rgraetz/cubli-redux/ME_Design/_AssembledMotorFlyWheel.FCStd

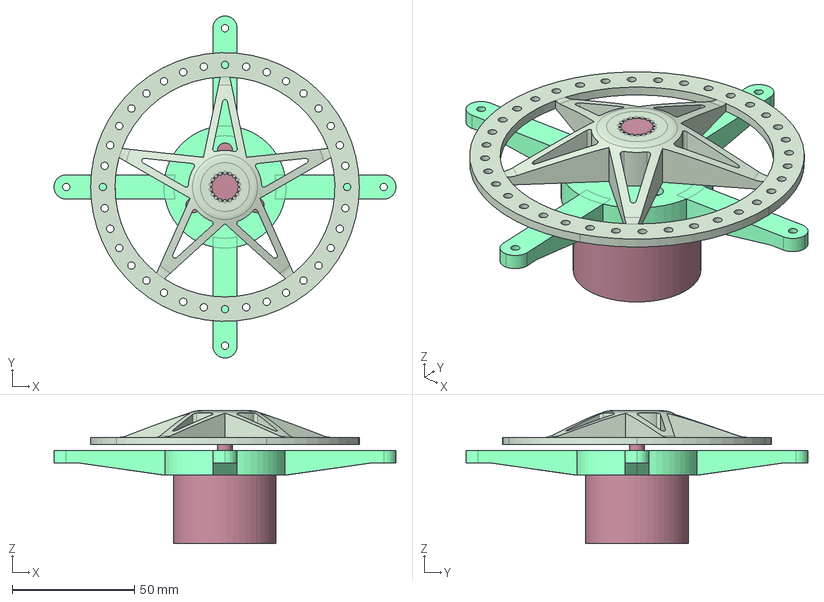
[picture p1: CAD file, 2022-12-11]
ME_Design/_AssembledMotorFlyWheel.FCStd
140.0 x 140.0 x 54.5 mm
Motor_001
MotorMount_001
ReactionWheel_001
