rgraetz/cubli-redux/ME_Design/_AssembledParts.FCStd

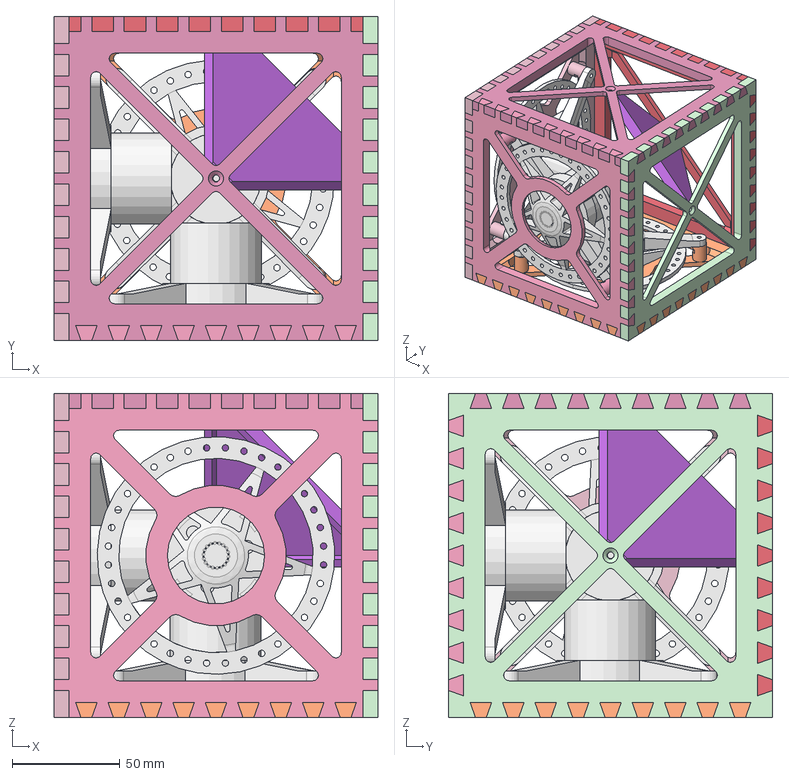
[picture p2: CAD file, 2022-12-11]
ME_Design/_AssembledParts.FCStd
150.0 x 150.0 x 150.0 mm
MotorSide_001
MotorSide_002
MotorSideKey_001
OtherSide_001
OtherSide_002
OtherSideKey_001
ElectronicsMount_001
_AssembledMotorFlyWheel_001
_AssembledMotorFlyWheel_002
_AssembledMotorFlyWheel_003
