rgraetz/cubli-redux/ME_Design/_backup/MotorSide.FCStd

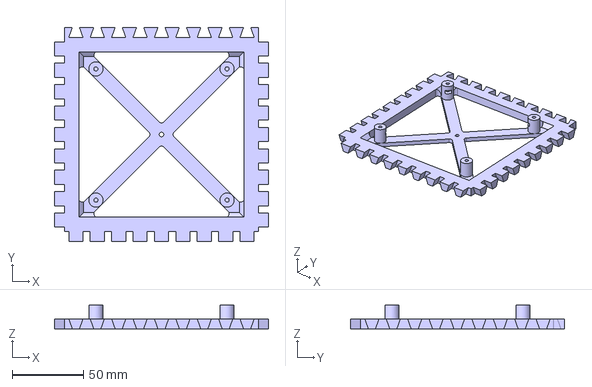
[picture p3: CAD file, 2022-12-11]
ME_Design/_backup/MotorSide.FCStd
150.0 x 150.0 x 16.5 mm
