rgraetz/cubli-redux/ME_Design/ElectronicsMount.FCStd

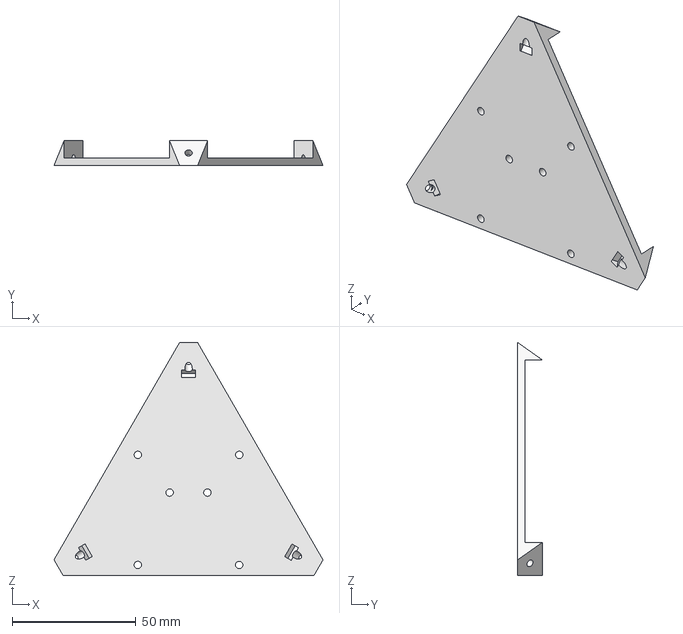
[picture p4: CAD file, 2022-12-11]
ME_Design/ElectronicsMount.FCStd
108.8 x 10.0 x 94.2 mm
