rgraetz/cubli-redux/ME_Design/Exports/ElectronicsMount-Part.3mf

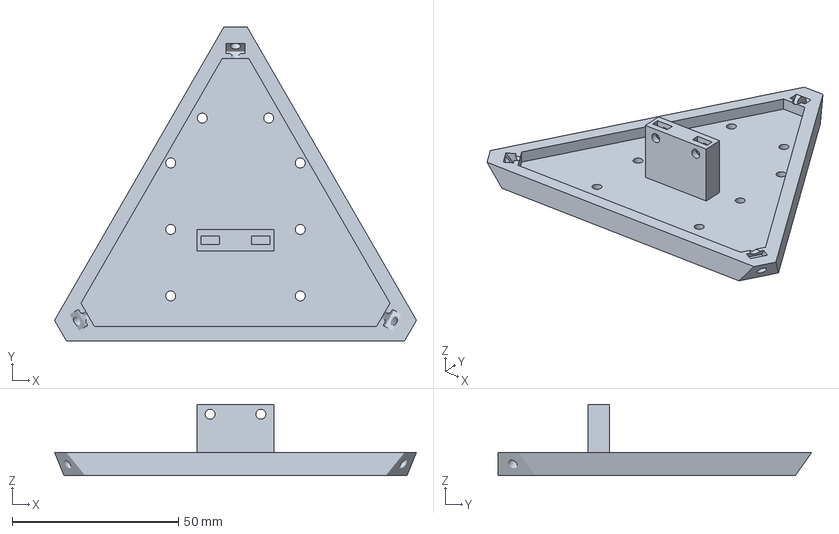
[picture p5: CAD file, 2022-12-11]
ME_Design/Exports/ElectronicsMount-Part.3mf
109.0 x 94.4 x 21.5 mm
