rgraetz/cubli-redux/ME_Design/_backup/MotorSideKey.FCStd

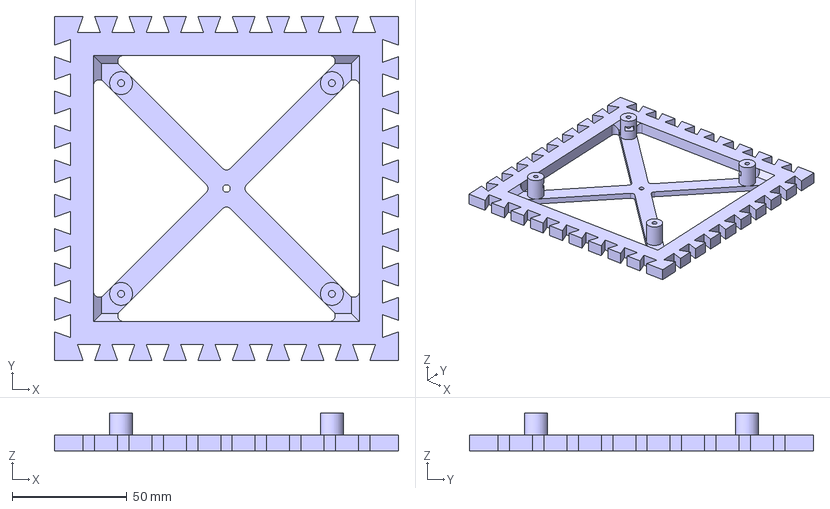
[picture p6: CAD file, 2022-12-11]
ME_Design/_backup/MotorSideKey.FCStd
150.0 x 150.0 x 16.5 mm
