rgraetz/cubli-redux/ME_Design/Exports/MotorSideKey-Part.stl

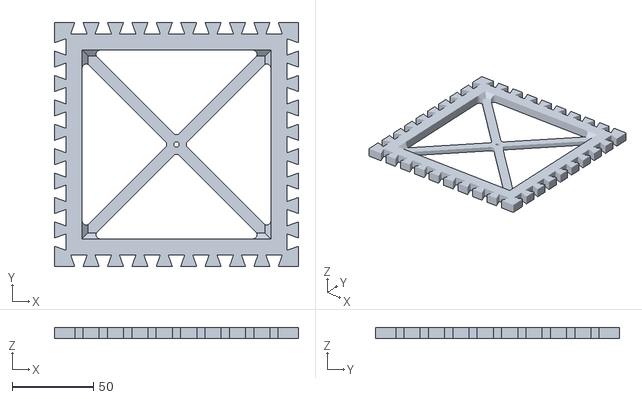
[picture p7: CAD file, 2022-12-11]
ME_Design/Exports/MotorSideKey-Part.stl
150.0 x 150.0 x 7.00
