rgraetz/cubli-redux/ME_Design/reaction_wheel_cube_3.stl

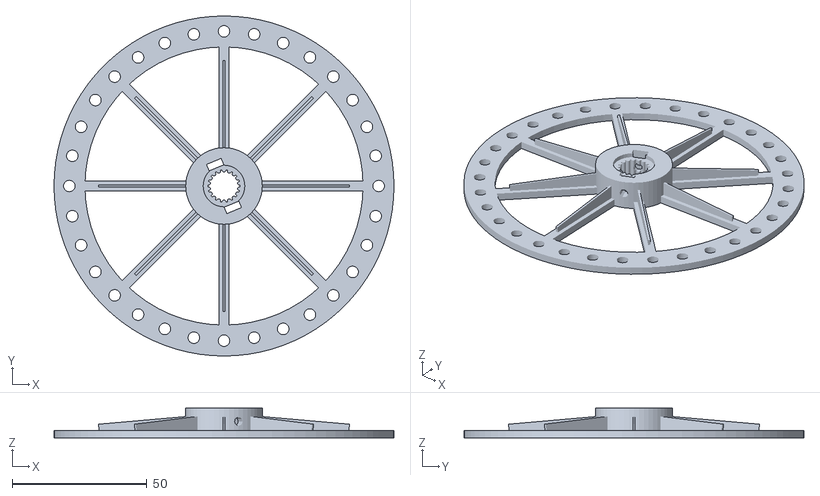
[picture p8: CAD file, 2022-12-11]
ME_Design/reaction_wheel_cube_3.stl
126.4 x 126.4 x 11.0
