rgraetz/cubli-redux/ME_Design/Exports/MotorSideKey-Part_DoveTest.stl

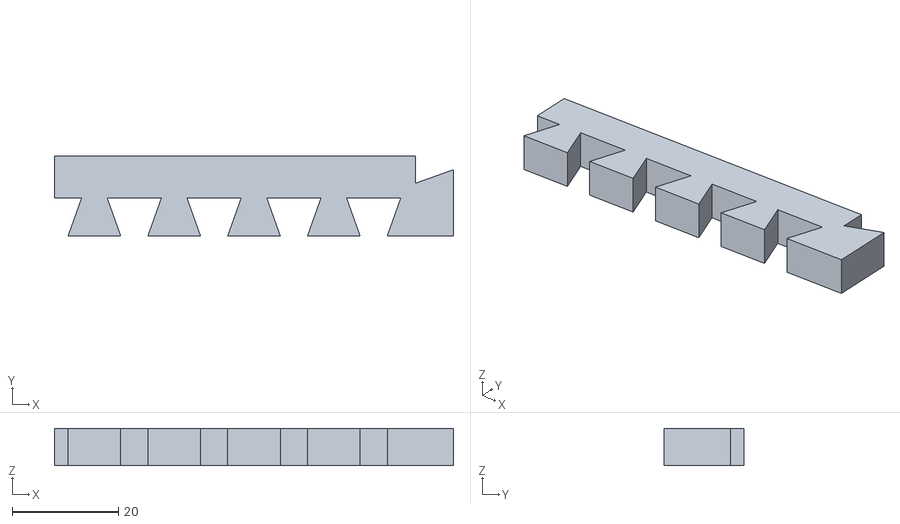
[picture p10: CAD file, 2022-12-11]
ME_Design/Exports/MotorSideKey-Part_DoveTest.stl
75.0 x 15.0 x 7.00
