rgraetz/cubli-redux/ME_Design/reaction_wheel_cube_2.stl

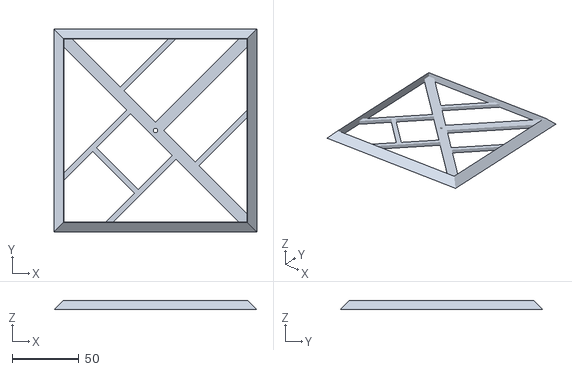
[picture p11: CAD file, 2022-12-11]
ME_Design/reaction_wheel_cube_2.stl
152.0 x 152.0 x 7.00
