rgraetz/cubli-redux/ME_Design/imuMount-Body.stl

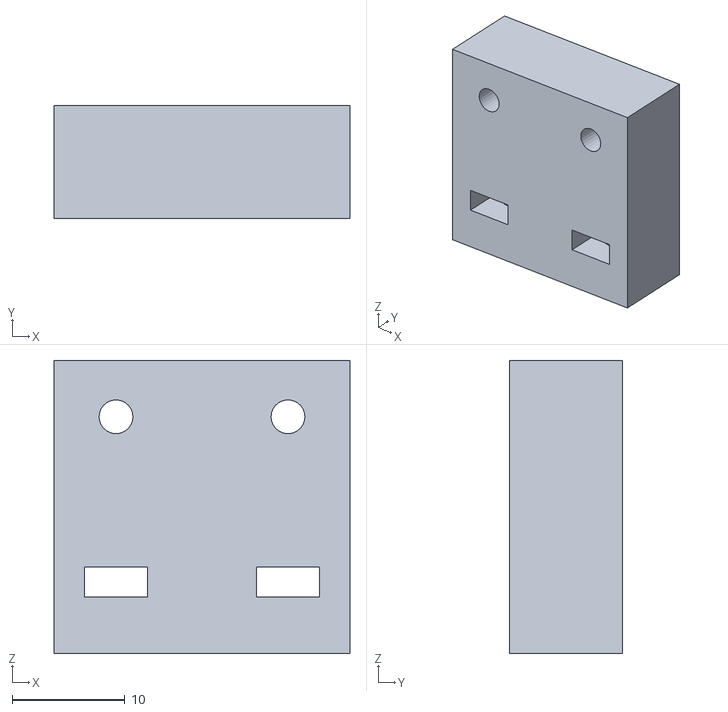
[picture p12: CAD file, 2022-12-11]
ME_Design/imuMount-Body.stl
26.2 x 10.0 x 26.0
