rgraetz/cubli-redux/ME_Design/reaction_wheel_cube_5.stl

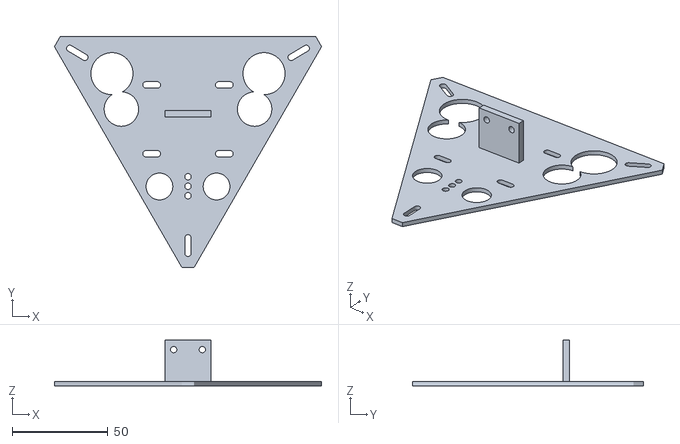
[picture p13: CAD file, 2022-12-11]
ME_Design/reaction_wheel_cube_5.stl
139.6 x 120.8 x 24.0
