rgraetz/cubli-redux/ME_Design/Exports/MotorMount-Part.3mf

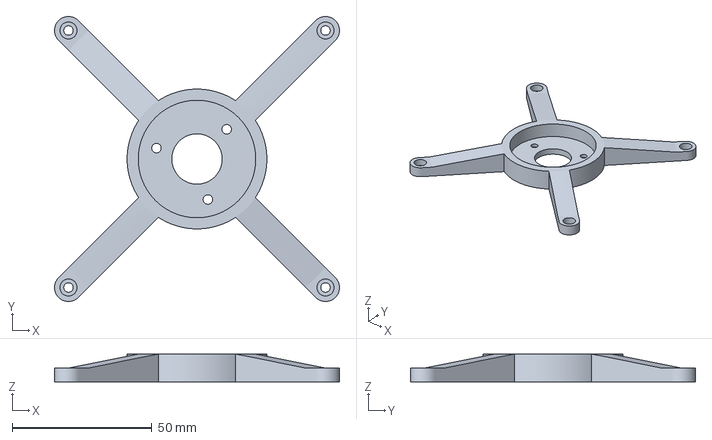
[picture p14: CAD file, 2022-12-11]
ME_Design/Exports/MotorMount-Part.3mf
101.9 x 101.9 x 10.0 mm
