rgraetz/cubli-redux/ME_Design/reaction_wheel_cube_8.stl

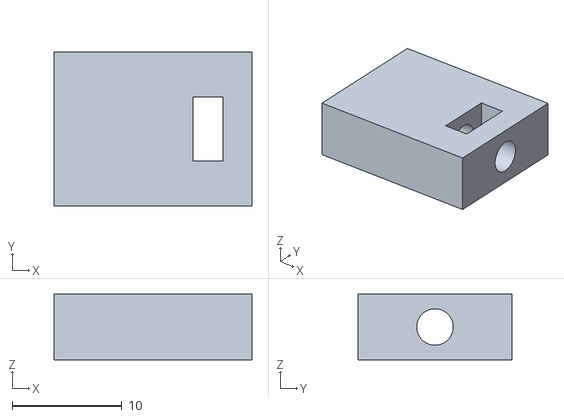
[picture p15: CAD file, 2022-12-11]
ME_Design/reaction_wheel_cube_8.stl
18.0 x 14.0 x 6.00
