rgraetz/cubli-redux/ME_Design/Exports/MotorSide-Part.stl

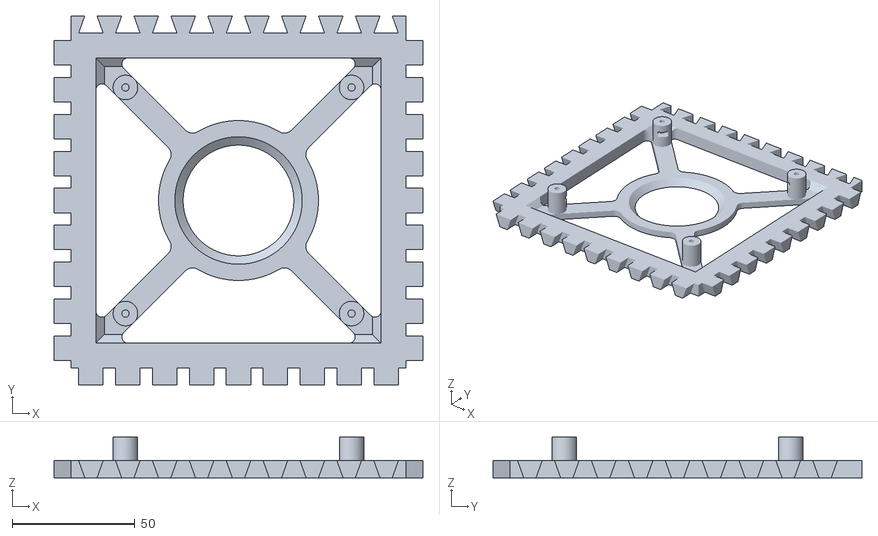
[picture p16: CAD file, 2022-12-11]
ME_Design/Exports/MotorSide-Part.stl
150.0 x 150.0 x 16.5
