rgraetz/cubli-redux/ME_Design/BatteryMount-Body.stl

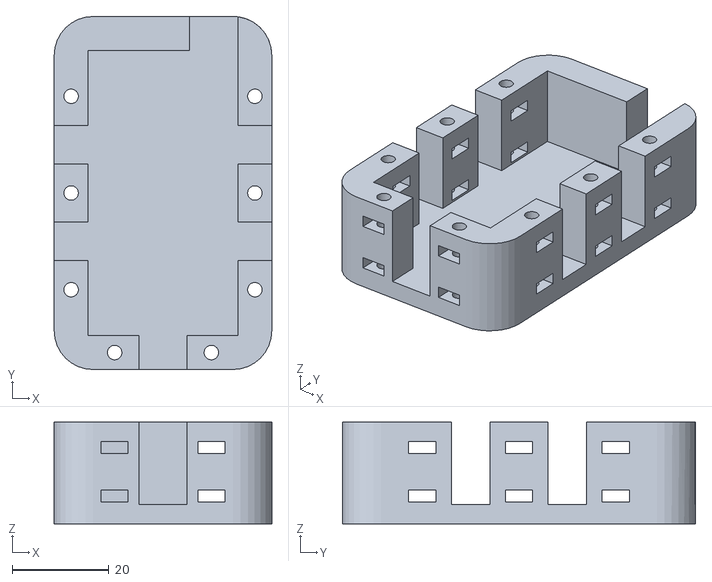
[picture p17: CAD file, 2022-12-11]
ME_Design/BatteryMount-Body.stl
45.0 x 73.0 x 21.0
