rgraetz/cubli-redux/ME_Design/Exports/ReactionWheel-Part.3mf

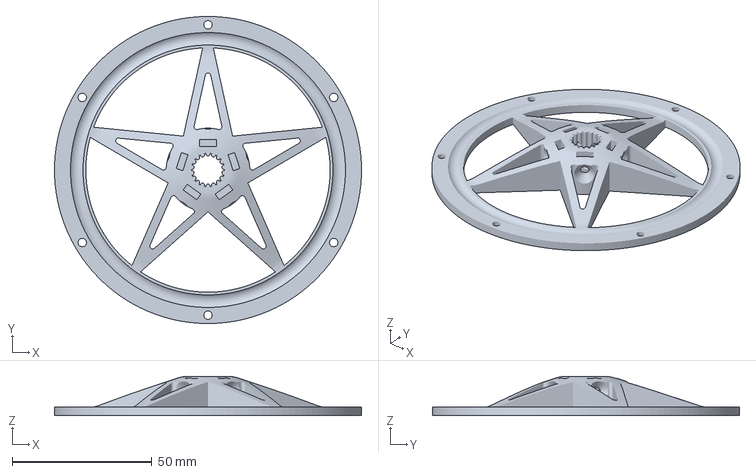
[picture p18: CAD file, 2022-12-11]
ME_Design/Exports/ReactionWheel-Part.3mf
110.0 x 110.0 x 14.0 mm
