rgraetz/cubli-redux/ME_Design/spacer-Body.stl

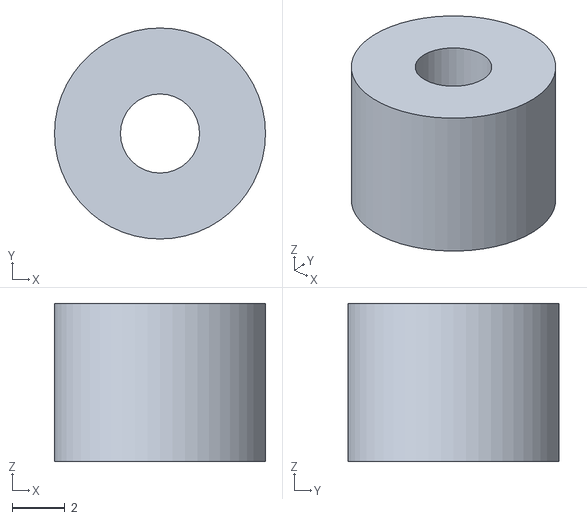
[picture p20: CAD file, 2022-12-11]
ME_Design/spacer-Body.stl
8.00 x 8.00 x 6.00
