rgraetz/cubli-redux/ME_Design/reaction_wheel_cube_4.stl

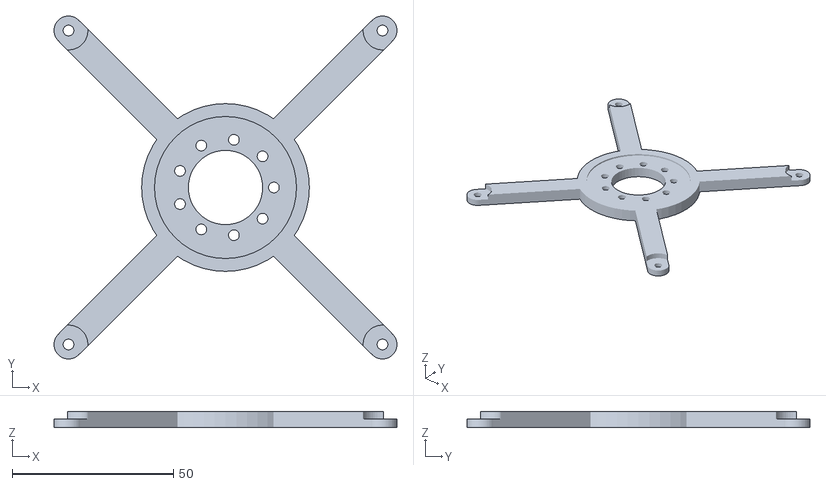
[picture p21: CAD file, 2022-12-11]
ME_Design/reaction_wheel_cube_4.stl
106.3 x 106.3 x 5.00
