rgraetz/cubli-redux/ME_Design/wireStrainSpacer-Body.stl

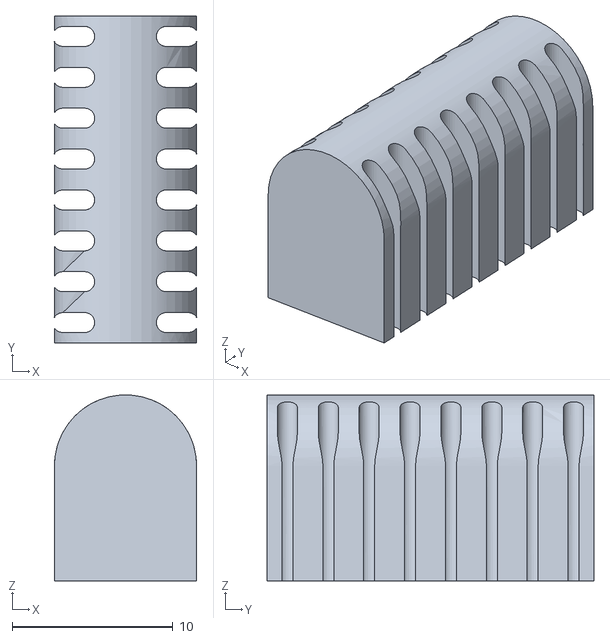
[picture p22: CAD file, 2022-12-11]
ME_Design/wireStrainSpacer-Body.stl
8.83 x 20.3 x 11.6
