rgraetz/cubli-redux/ME_Design/reaction_wheel_cube_1.stl

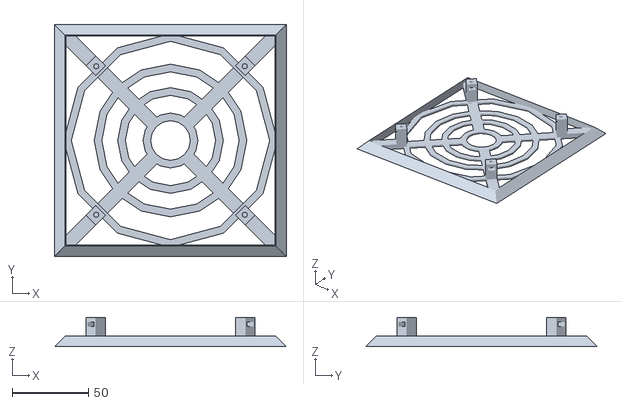
[picture p23: CAD file, 2022-12-11]
ME_Design/reaction_wheel_cube_1.stl
152.0 x 152.0 x 19.3
