rgraetz/cubli-redux/ME_Design/MotorSideKey.FCStd

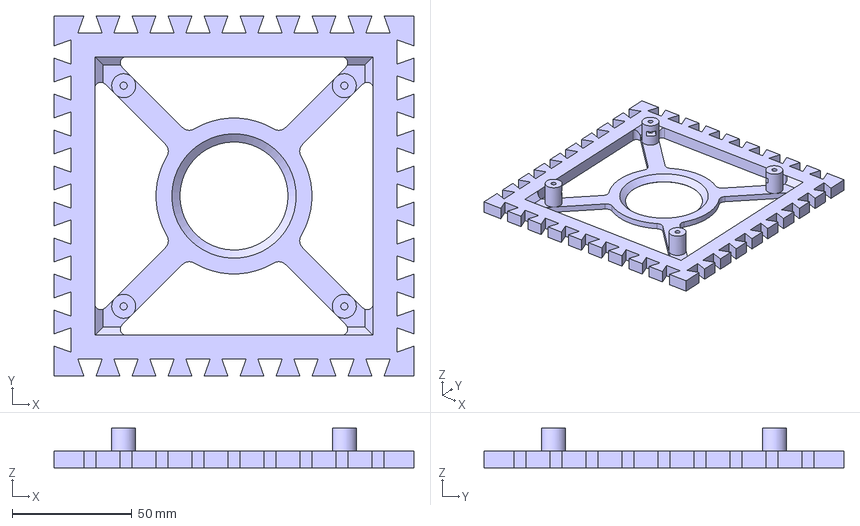
[picture p24: CAD file, 2022-12-11]
ME_Design/MotorSideKey.FCStd
150.0 x 150.0 x 16.5 mm
