rgraetz/cubli-redux/ME_Design/reaction_wheel_cube_9.stl

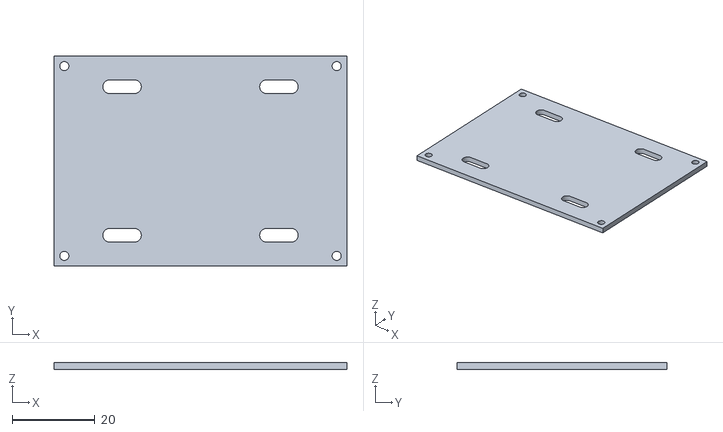
[picture p25: CAD file, 2022-12-11]
ME_Design/reaction_wheel_cube_9.stl
71.0 x 51.0 x 1.60
