rgraetz/cubli-redux/ME_Design/MotorMount.FCStd

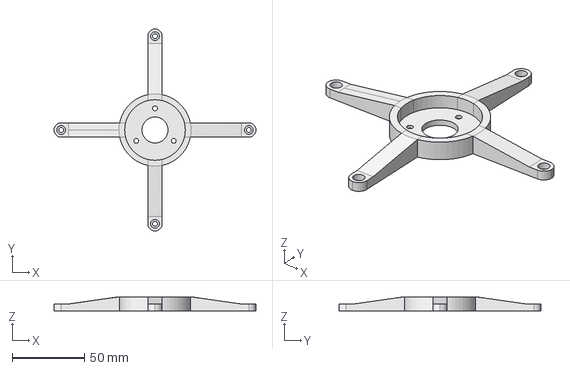
[picture p26: CAD file, 2022-12-11]
ME_Design/MotorMount.FCStd
140.0 x 140.0 x 10.0 mm
