rgraetz/cubli-redux/ME_Design/Motor.FCStd

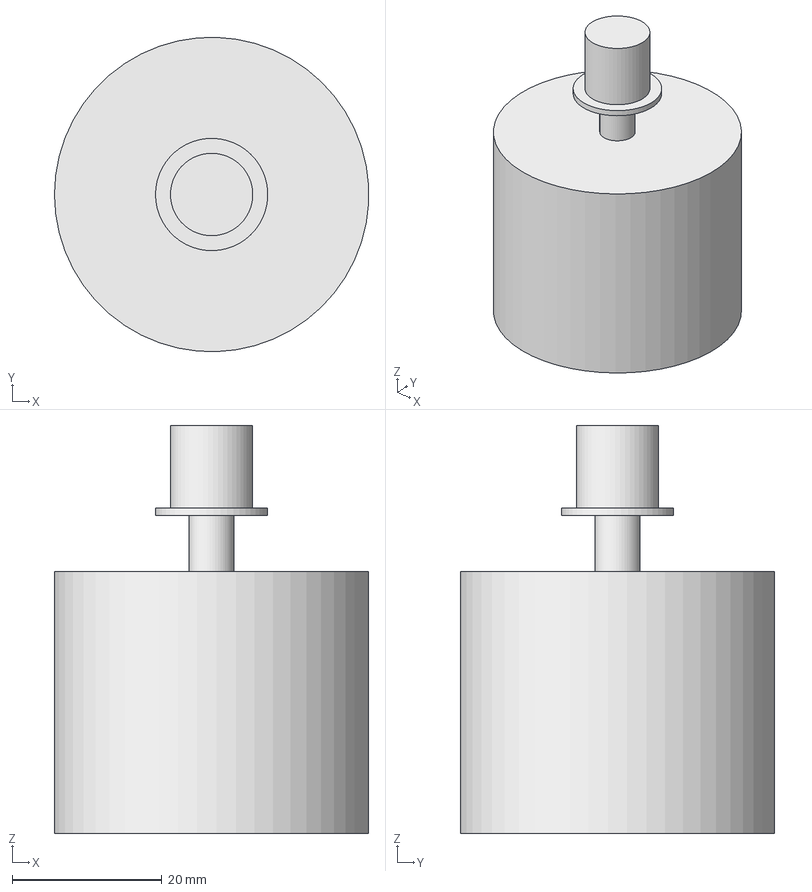
[picture p27: CAD file, 2022-12-11]
ME_Design/Motor.FCStd
42.0 x 42.0 x 54.5 mm
