rgraetz/cubli-redux/ME_Design/reaction_wheel_cube_6.stl

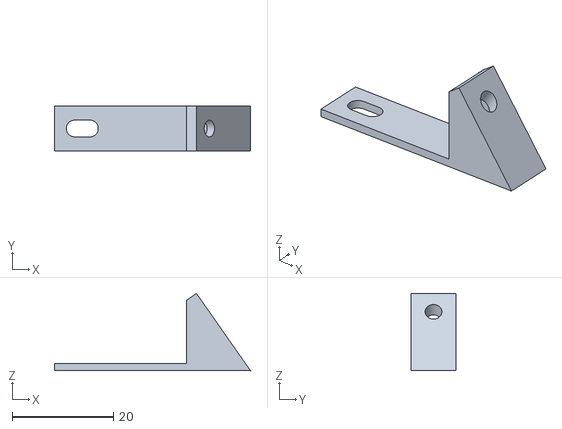
[picture p28: CAD file, 2022-12-11]
ME_Design/reaction_wheel_cube_6.stl
38.8 x 9.00 x 15.3
