rgraetz/cubli-redux/ME_Design/ReactionWheel-PartBody.stl

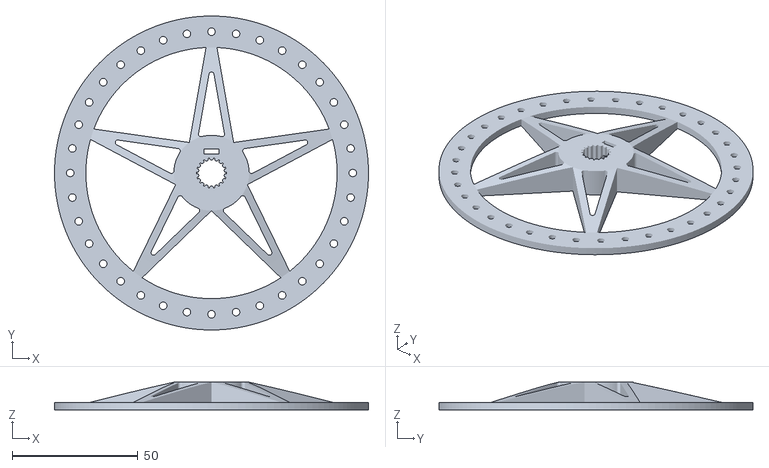
[picture p29: CAD file, 2022-12-11]
ME_Design/ReactionWheel-PartBody.stl
125.0 x 125.0 x 11.0
