rgraetz/cubli-redux/ME_Design/BatteryMount_New-Body.stl

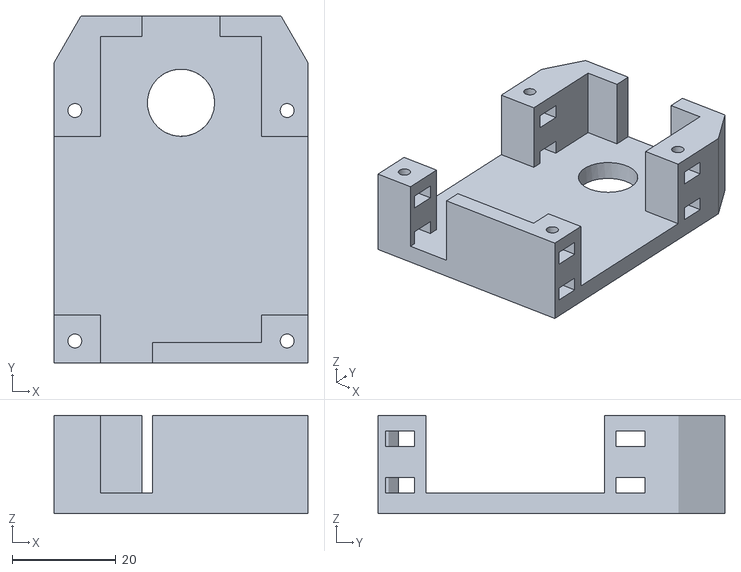
[picture p30: CAD file, 2022-12-11]
ME_Design/BatteryMount_New-Body.stl
49.0 x 67.0 x 19.0
