rgraetz/cubli-redux/ME_Design/ElectronicsMount_Org.FCStd

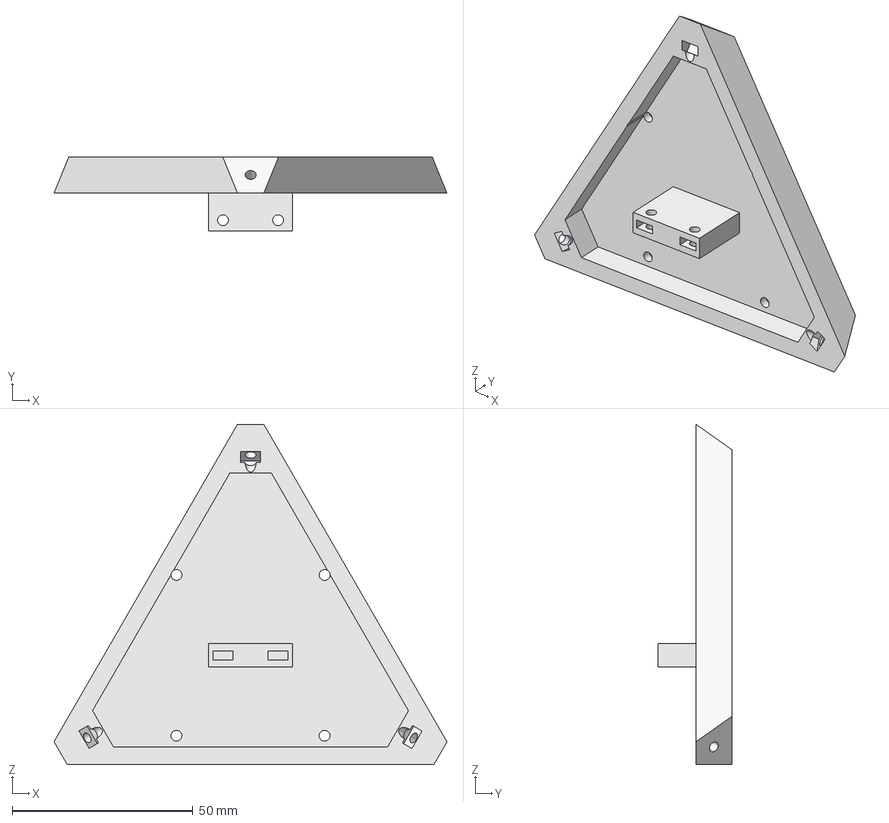
[picture p31: CAD file, 2022-12-11]
ME_Design/ElectronicsMount_Org.FCStd
108.8 x 20.5 x 94.2 mm
