rgraetz/cubli-redux/ME_Design/reaction_wheel_cube_7.stl

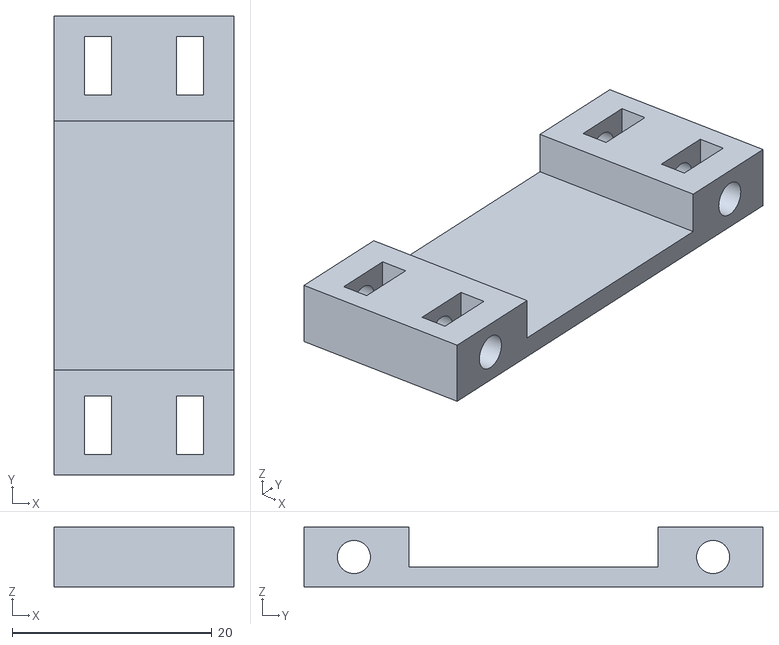
[picture p32: CAD file, 2022-12-11]
ME_Design/reaction_wheel_cube_7.stl
18.0 x 46.0 x 6.00
