rgraetz/cubli-redux/(list of files, cad)

Other CAD files:
ME_Design/OtherSideKey.FCStd
ME_Design/Exports/1X_CustomSupport_ReactionWheel-Part.3mf
ME_Design/cube_wheel_6mm_hole.stl
ME_Design/OtherSide.FCStd
ME_Design/spacer.FCStd
ME_Design/MotorSide.FCStd
ME_Design/OtherSideKeyNew.FCStd
ME_Design/imuMount.FCStd
ME_Design/ElectronicsMount-PartBody.stl
ME_Design/ReactionWheel.FCStd
ME_Design/BatteryMount.FCStd
ME_Design/wireStrainSpacer.FCStd
ME_Design/BatteryMount_New.FCStd
ME_Design/Exports/ElectronicsMount-Part.stl
ME_Design/Exports/MotorMount-Part.stl
ME_Design/Exports/ReactionWheel-Part.stl
ME_Design/ReactionWheel-Part.stl
