rgraetz/cubli-redux/(threads)

Thread 1 (2022-09-03):

Microcontroller Selection

rgraetz, 2022-09-03:
I/O requirements:
- 1x battery voltage sense analog input
- I2C communication (SDA/SCL)
- 2x per motor encoder inputs
- 3x per motor control outputs (PWM, direction and brake)

Potential candidates:
- adafruit-huzzah32-esp32-feather
https://cdn-learn.adafruit.com/downloads/pdf/adafruit-huzzah32-esp32-feather.pdf
- AITRIP ES32
https://www.amazon.com/gp/product/B0B19KRPRC/ref=ppx_yo_dt_b_asin_title_o00_s00?ie=UTF8&psc=1

Thread 2 (2022-09-03):

Motor Selection

rgraetz, 2022-09-03:
Nidec 24H
- built in speed controller and brake
- interface with PWM speed, direction and brake digital signals

Ordering Information:
- $5.09 each, $13.46 shipping for 4
https://www.aliexpress.com/item/3256801500013143.html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

Thread 3 (2022-09-04):

Sensor Selection

rgraetz, 2022-09-04:
- MPU6050 ie. https://www.adafruit.com/product/3886#technical-details
- daisy chain I2C connection with https://www.adafruit.com/product/4210
- How to perform sensor fusion if using >1 MPU

Thread 5 (2022-09-05):

AITRIP ESP32 Bringup Documentation

rgraetz, 2022-09-05:
- partial instructions through -> https://randomnerdtutorials.com/installing-the-esp32-board-in-arduino-ide-windows-instructions/
- install Arduino IDE and ESP32 board manager URL -> https://raw.githubusercontent.com/espressif/arduino-esp32/gh-pages/package_esp32_index.json
- select board from Arduino IDE -> Tools -> Board: -> ESP32 Dev Module
- plugin board and device should show up in device manager
- select port from Arduino IDE -> Tools -> Port: -> ...
- run example ie. Wifi -> WiFiScan to verify everything is working

Thread 6 (2022-09-05):

Schematic and Diagrams

rgraetz, 2022-09-05:
Inkscape SVG editor
- https://blog.adafruit.com/2019/07/11/automating-the-making-of-beautiful-pinout-diagrams-for-microcontroller-boards-documentation-at_makers/
- PCB or chip SVG https://fritzing.org
-

Thread 7 (2022-09-05):

MPU6050 Bring-up and Testing

rgraetz, 2022-09-05:
**Bring-up Documentation**
- https://lastminuteengineers.com/mpu6050-accel-gyro-arduino-tutorial/
- https://howtomechatronics.com/tutorials/arduino/arduino-and-mpu6050-accelerometer-and-gyroscope-tutorial/
- default I2C address 0x68

**Testing**
