rgraetz/cubli-redux/(list of files, drawings)

Other design files:
EE_Design/Cublic.dsn
