rgraetz/cubli-redux/EE_Design/Cublic.kicad_pcb

## KiCad design EE_Design/Cublic.kicad_pcb (2022-12-11)

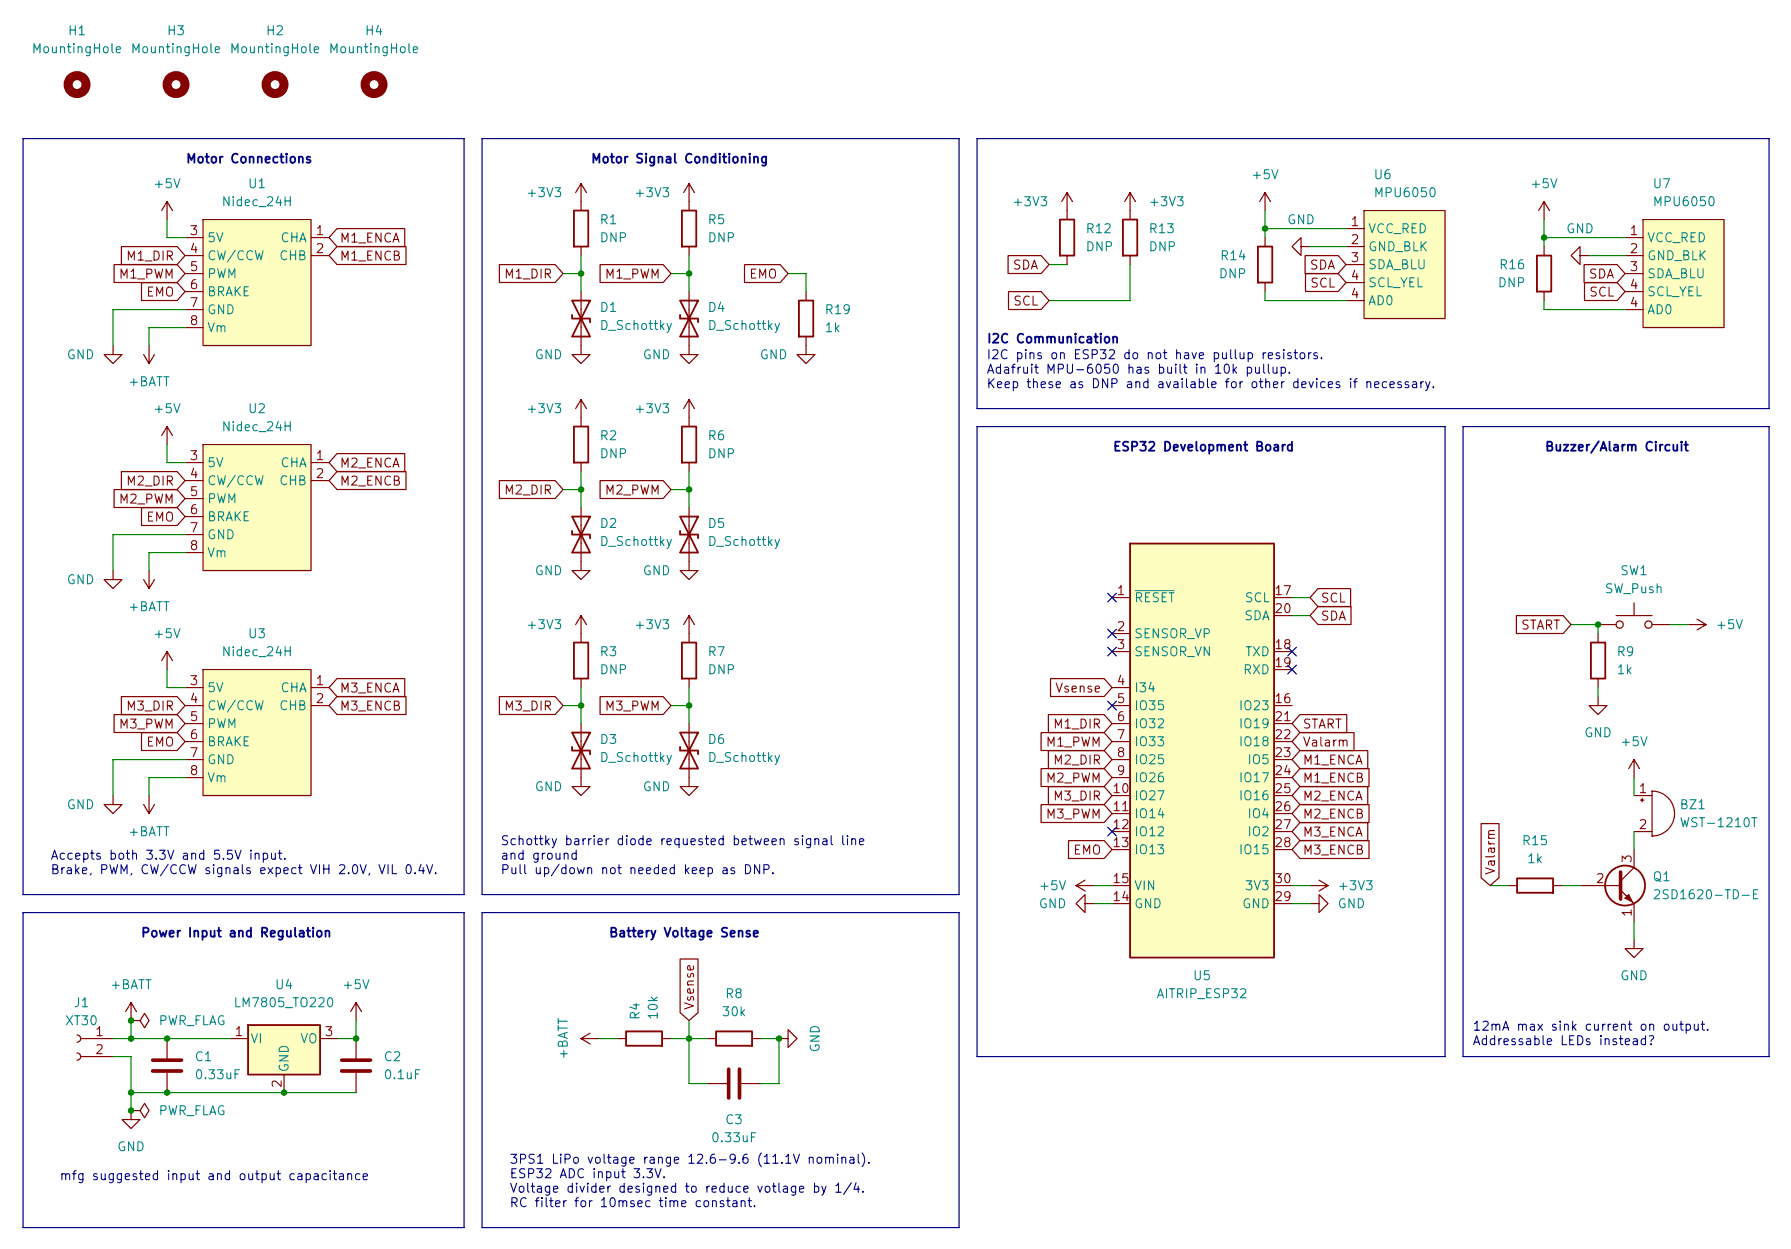
[picture p33: schematic Cublic.kicad_sch]

Parts:
BZ1: WST-1210T; Buzzer_12x9.5RM7.6
C1, C3: 0.33uF; C_0603_1608Metric_Pad1.08x0.95mm_HandSolder
C2: 0.1uF; C_0603_1608Metric_Pad1.08x0.95mm_HandSolder
D1, D2, D3, D4, D5, D6: D_Schottky; D_0603_1608Metric_Pad1.05x0.95mm_HandSolder; MPN SP1103C-01UTG
H1, H2, H3, H4: MountingHole; MountingHole_3.2mm_M3
J1: XT30; XT30PW_M
Q1: 2SD1620-TD-E; TO-243AA
R1, R2, R3, R5, R6, R7, R12, R13, R14, R16: DNP; R_0603_1608Metric_Pad0.98x0.95mm_HandSolder
R4: 10k; R_0603_1608Metric_Pad0.98x0.95mm_HandSolder
R8: 30k; R_0603_1608Metric_Pad0.98x0.95mm_HandSolder
R9, R15, R19: 1k; R_0603_1608Metric_Pad0.98x0.95mm_HandSolder
SW1: SW_Push; PinHeader_1x02_P2.54mm_Vertical
U1, U2, U3: Nidec_24H; PinHeader_1x08_P2.54mm_StrainRelief
U4: LM7805_TO220; TO-220-3_Horizontal_TabDown
U5: AITRIP_ESP32
U6, U7: MPU6050; Pinheader_1x05_P2.54mm_StrainRelief

Connections:
+3V3: R1.1, R2.1, R3.1, R5.1, R6.1, R7.1, R12.1, R13.1, U5.30 (3V3)
+5V: BZ1.1 (-), C2.1, R14.1, R16.1, SW1.2, U1.3 (5V), U2.3 (5V), U3.3 (5V), U4.3 (VO), U5.15 (VIN), U6.1 (VCC_RED), U7.1 (VCC_RED)
+BATT: C1.1, J1.1, R4.1, U1.8 (Vm), U2.8 (Vm), U3.8 (Vm), U4.1 (VI)
EMO: R19.1, U1.6 (BRAKE), U2.6 (BRAKE), U3.6 (BRAKE), U5.13 (IO13)
GND: C1.2, C2.2, C3.2, D1.2 (A2), D2.2 (A2), D3.2 (A2), D4.2 (A2), D5.2 (A2), D6.2 (A2), J1.2, Q1.1 (E), R8.2, R9.1, R19.2, U1.7 (GND), U2.7 (GND), U3.7 (GND), U4.2 (GND), U5.14 (GND), U5.29 (GND), U6.2 (GND_BLK), U7.2 (GND_BLK)
M1_DIR: D1.1 (A1), R1.2, U1.4 (CW/CCW), U5.6 (IO32)
M1_ENCA: U1.1 (CHA), U5.23 (IO5)
M1_ENCB: U1.2 (CHB), U5.24 (IO17)
M1_PWM: D4.1 (A1), R5.2, U1.5 (PWM), U5.7 (IO33)
M2_DIR: D2.1 (A1), R2.2, U2.4 (CW/CCW), U5.8 (IO25)
M2_ENCA: U2.1 (CHA), U5.25 (IO16)
M2_ENCB: U2.2 (CHB), U5.26 (IO4)
M2_PWM: D5.1 (A1), R6.2, U2.5 (PWM), U5.9 (IO26)
M3_DIR: D3.1 (A1), R3.2, U3.4 (CW/CCW), U5.10 (IO27)
M3_ENCA: U3.1 (CHA), U5.27 (IO2)
M3_ENCB: U3.2 (CHB), U5.28 (IO15)
M3_PWM: D6.1 (A1), R7.2, U3.5 (PWM), U5.11 (IO14)
unnamed: BZ1.2 (+), Q1.3 (C)
unnamed: Q1.2 (B), R15.2
SDA: R12.2, U5.20 (SDA), U6.3 (SDA_BLU), U7.3 (SDA_BLU)
START: R9.2, SW1.1, U5.21 (IO19)
Valarm: R15.1, U5.22 (IO18)
Vsense: C3.1, R4.2, R8.1, U5.4 (I34)

Notes on the sheet:
Accepts both 3.3V and 5.5V input. Brake, PWM, CW/CCW signals expect VIH 2.0V, VIL 0.4V.
Motor Signal Conditioning
ESP32 Development Board
12mA max sink current on output. Addressable LEDs instead?
Buzzer/Alarm Circuit
mfg suggested input and output capacitance
Power Input and Regulation
I2C pins on ESP32 do not have pullup resistors. Adafruit MPU-6050 has built in 10k pullup. Keep these as DNP and available for other devices if necessary.
Schottky barrier diode requested between signal line and ground Pull up/down not needed keep as DNP.
Motor Connections
Battery Voltage Sense
I2C Communication
3PS1 LiPo voltage range 12.6-9.6 (11.1V nominal). ESP32 ADC input 3.3V. Voltage divider designed to reduce votlage by 1/4. RC filter for 10msec time constant.

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
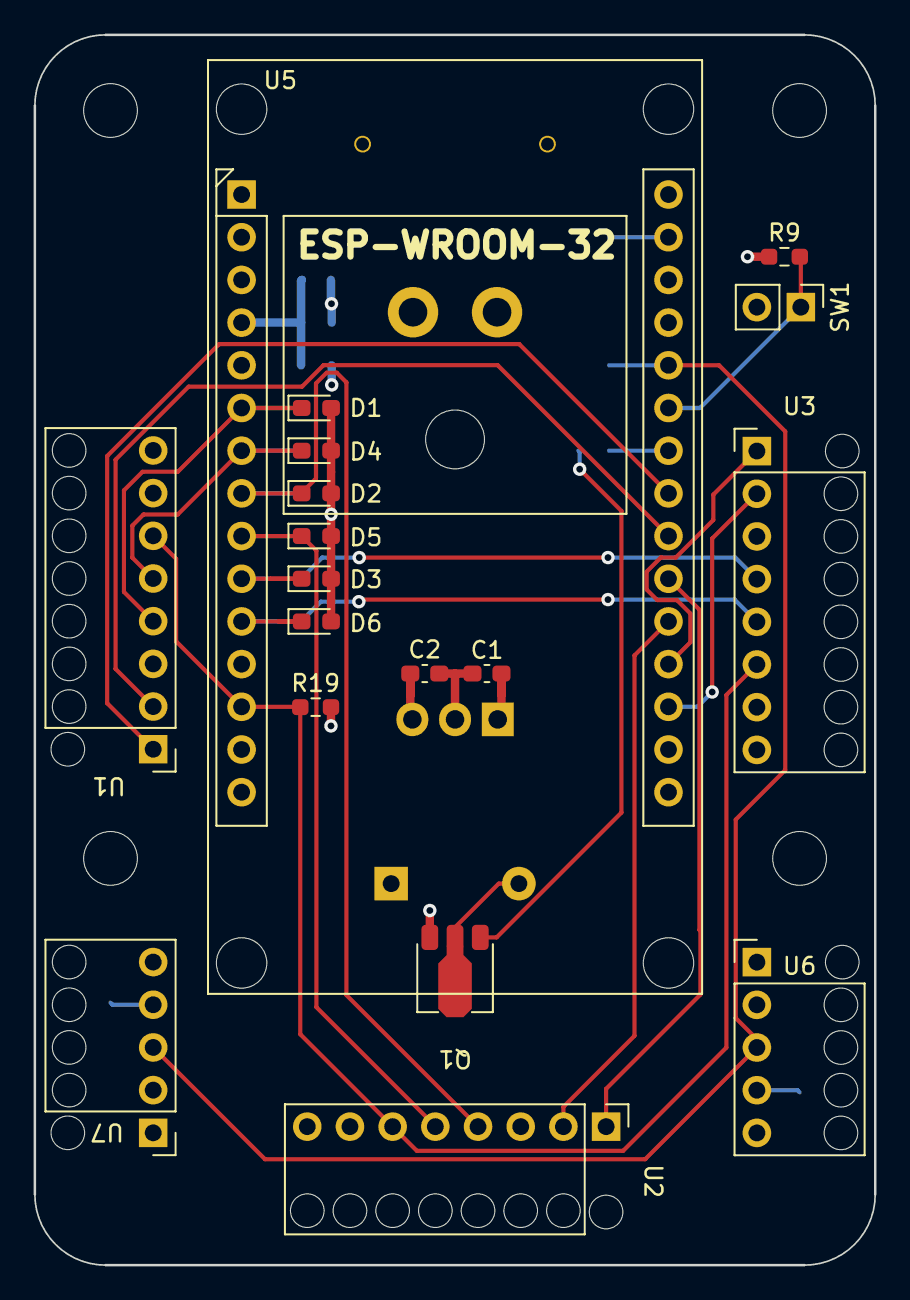
[picture p34: board Cublic.kicad_pcb from above]

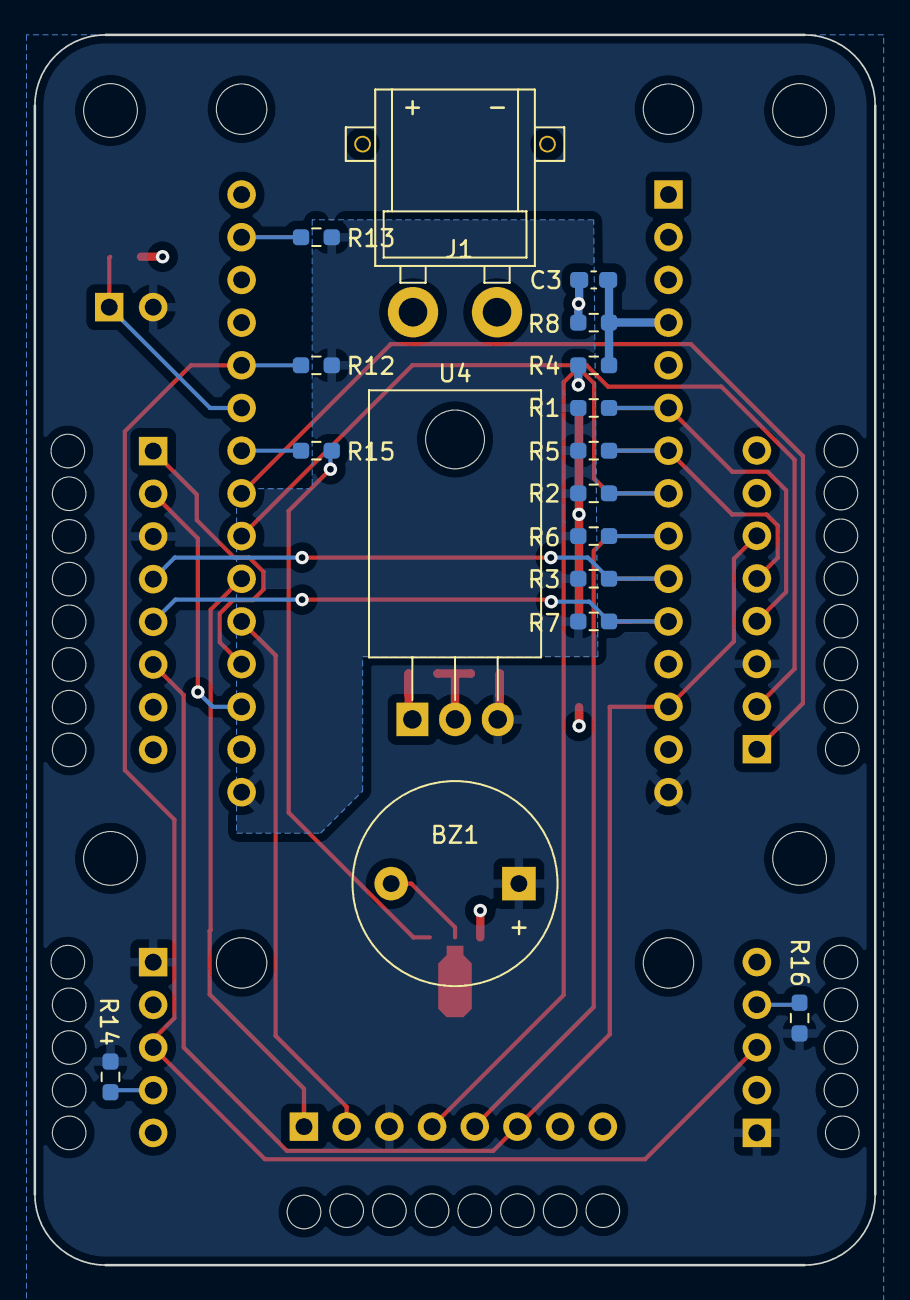
[picture p35: board Cublic.kicad_pcb from below]

Board: 4 copper layers, 50.0 x 73.2 mm, 39 parts (17 on the bottom side), 26 nets.
