rgraetz/cubli-redux/Firmware/main/main.ino

#include "main.h"

// POSITION FEEDBACK
DigitalEncoder M1_ENC(M1_CHA_GPIO, M1_CHB_GPIO, 1);
DigitalEncoder M2_ENC(M2_CHA_GPIO, M2_CHB_GPIO, 2);
DigitalEncoder M3_ENC(M3_CHA_GPIO, M3_CHB_GPIO, 3);

MPU_6050 MPU(MPU_ADDR, 0, 1);
RobotCS RobotAngles(1);
float u1[3] = {-0.81649658, 0.40824829, 0.40824829};
float u2[3] = {0.0, -0.70710678, 0.70710678};
float u3[3] = {0.57735027, 0.57735027, 0.57735027};
// AngleTransformation MotorAngles(u1, u2, u3);

// CONTROL GAINS
// zero-crossing [Hz], integrator cutoff [Hz], low-pass cutoff [Hz], gain, lead-lag phase bump
float control_gains[6][5] = {{10.0, 0.0, 200.0, 1000.0, 3.0}, // edge velocity control gains
                             {1.0, 0.001, 10.0, 0.01, 0.0},   // edge position control gains
                             {1.0, 0.075, 1.0, 0.002, 0.0},   // edge balance control gains
                             {20.0, 0.0, 200.0, 1000.0, 3.0}, // corner velocity control gains
                             {1.0, 0.005, 1.0, 0.1, 0.0},     // corner position control gains
                             {1.0, 0.15, 1.0, 0.0125, 0.0}};  // corner balance control gains

// CONTROL
float m1_pos, m1_vel;
float m2_pos, m2_vel;
float m3_pos, m3_vel;

// EDGE CONTROL
ControlAlgo M1_Control(M1_DIR_GPIO, 0, M1_PWM_GPIO, 100, 1); // Z-direction motor "black"
ControlAlgo M2_Control(M2_DIR_GPIO, 0, M2_PWM_GPIO, 100, 2); // Y-direction motor "silver"
ControlAlgo M3_Control(M3_DIR_GPIO, 0, M3_PWM_GPIO, 100, 3); // X-direction motor "purple"

// CORNER CONTROL
ControlAlgo R_Control(M1_DIR_GPIO, 0, M1_PWM_GPIO, 100, 1);
ControlAlgo P_Control(M2_DIR_GPIO, 0, M2_PWM_GPIO, 100, 2);
ControlAlgo Y_Control(M3_DIR_GPIO, 0, M3_PWM_GPIO, 100, 3);

int current_State = 0;
int next_State = 0;
int control_Error = 0;
int late = 0;
int mode = -1;
int controlIdx = -1;

#if !defined(CONFIG_BT_ENABLED) || !defined(CONFIG_BLUEDROID_ENABLED)
#error Bluetooth is not enabled! Please run `make menuconfig` to and enable it
#endif

BluetoothSerial SerialBT;
int diag = 1;
int edge = 1;
float frf_amp = 50;
float frf_freq = 1.0;

void setup()
{
    Serial.begin(115200);
    Serial.print("State,Error*10,Pitch,AccY,GyroY,Out,PWM,Target");
    SerialBT.begin("ESP32_Cube");
    Serial.println("Application started");

    pinMode(EMO_GPIO, OUTPUT);
    digitalWrite(EMO_GPIO, LOW);

    pinMode(BUZZ_GPIO, OUTPUT);
    digitalWrite(BUZZ_GPIO, LOW);
    pinMode(BATT_AIN, INPUT);

    // MPU initialization
    beep(1);
    MPU.Init();
    beep(1);
}

void beep(int num)
{
    for (int i = 0; i < num; i++)
    {
        digitalWrite(BUZZ_GPIO, HIGH);
        delay(70);
        digitalWrite(BUZZ_GPIO, LOW);
        if (i < num - 1)
            delay(70);
    }
}

void Stop()
{
    // disable and reset control
    M1_Control.Disable();
    M2_Control.Disable();
    M3_Control.Disable();
    R_Control.Disable();
    P_Control.Disable();
    Y_Control.Disable();
    digitalWrite(EMO_GPIO, LOW); // brake on
}

void loop()
{
    // CONTROL STATE MACHINE
    current_State = next_State;
    if (current_State == INIT) // initialization state
    {
        control_Error = 0;
        // update transition timing
        edge1_t = millis();
        edge2_t = millis();
        edge3_t = millis();

        // move to next state
        next_State = IDLE;
    }
    else if (current_State == IDLE) // wait for control inputs
    {
        if ((abs(RobotAngles.roll - EDGE1_R) > EDGE_TOLERANCE) || (abs(RobotAngles.pitch - EDGE1_P) > EDGE_TOLERANCE) || (digitalRead(START_GPIO) == 0))
            edge1_t = millis();
        if ((abs(RobotAngles.roll - EDGE2_R) > EDGE_TOLERANCE) || (abs(RobotAngles.pitch - EDGE2_P) > EDGE_TOLERANCE) || (digitalRead(START_GPIO) == 0))
            edge2_t = millis();
        if ((abs(RobotAngles.roll - EDGE3_R) > EDGE_TOLERANCE) || (abs(RobotAngles.pitch - EDGE3_P) > EDGE_TOLERANCE) || (digitalRead(START_GPIO) == 0))
            edge3_t = millis();
        if ((abs(RobotAngles.roll - CORNER_R) > EDGE_TOLERANCE) || (abs(RobotAngles.pitch - CORNER_P) > EDGE_TOLERANCE) || (digitalRead(START_GPIO) == 0))
            corner_t = millis();

        if (millis() - edge1_t > EN_PERIOD_MSEC)
        {
            Serial.println("Edge 1 Control Enabled!");
            beep(1);
            next_State = EDGE1;
        }
        else if (millis() - edge2_t > EN_PERIOD_MSEC)
        {
            Serial.println("Edge 2 Control Enabled!");
            beep(2);
            next_State = EDGE2;
        }
        else if (millis() - edge3_t > EN_PERIOD_MSEC)
        {
            Serial.println("Edge 3 Control Enabled!");
            beep(3);
            next_State = EDGE3;
        }
        else if (millis() - corner_t > EN_PERIOD_MSEC)
        {
            Serial.println("Corner Control Enabled!");
            beep(4);
            next_State = CORNER;
        }
    }
    else
    {
        if ((control_Error > 0) || (digitalRead(START_GPIO) == 0))
        {
            if (control_Error == 1)
                Serial.println("Error Threshold Exceeded...");
            else
                Serial.println("Control Disabled...");
            beep(1);
            next_State = INIT;
        }
    }

    // MEASUREMENT UPDATE
    if (micros() - measurement_t >= MEASUREMENT_PERIOD_USEC)
    {
        // measurement update time
        measurement_late = micros() - measurement_t - MEASUREMENT_PERIOD_USEC;
        measurement_t = micros();

        // update measurements
        MPU.GetMeasurement();                                                                                   // sensor coordinate system
        RobotAngles.MPU2Robot(MPU._AcX, MPU._AcY, MPU._AcZ, MPU._gyroAngleX, MPU._gyroAngleY, MPU._gyroAngleZ); // robot coordinate system
        // MotorAngles.Transform(RobotAngles.roll, RobotAngles.pitch, RobotAngles.yaw);                            // motor coordinate system

        // single edge control
        if (current_State != CORNER)
        {
            m1_pos = -0.5 * (RobotAngles.roll + RobotAngles.pitch);
            m1_vel = -0.5 * (RobotAngles.GetGyroX() + RobotAngles.GetGyroY());

            m2_pos = RobotAngles.roll;
            m2_vel = RobotAngles.GetGyroX();

            m3_pos = RobotAngles.pitch;
            m3_vel = RobotAngles.GetGyroY();
        }
    }

    // CONTROL UPDATE
    if (micros() - control_t >= CONTROL_PERIOD_USEC)
    {
        // control update time
        control_late = micros() - control_t - CONTROL_PERIOD_USEC;
        control_t = micros();
        if (current_State == INIT)
        {
            CalcGains(-1);
            // stop motors
            Stop();
        }
        else if (current_State == IDLE)
        {
            // stop motors
            Stop();
            // set control target
            M1_Control.SetTarget(m1_pos);
            M2_Control.SetTarget(m2_pos);
            M3_Control.SetTarget(m3_pos);
            R_Control.SetTarget(RobotAngles.roll);
            P_Control.SetTarget(RobotAngles.pitch);
            Y_Control.SetTarget(0.0);
        }
        else if (current_State == EDGE1)
        { // black edge
            // brake off
            digitalWrite(EMO_GPIO, HIGH);
            // control calculations
            control_Error = M1_Control.ControlUpdate(m1_pos, m1_vel, 1);
            M2_Control.Disable();
            M3_Control.Disable();
            // tilt error detection
            if (abs(M1_Control._pos_error) > ERROR_THRESHOLD)
                control_Error = 1;
        }
        else if (current_State == EDGE2)
        { // silver edge
            // brake off
            digitalWrite(EMO_GPIO, HIGH);
            // control calculations
            M1_Control.Disable();
            control_Error = M2_Control.ControlUpdate(m2_pos, m2_vel, 1);
            M3_Control.Disable();
            // tilt error detection
            if (abs(M2_Control._pos_error) > ERROR_THRESHOLD)
                control_Error = 1;
        }
        else if (current_State == EDGE3)
        { // purple edge
            // brake off
            digitalWrite(EMO_GPIO, HIGH);
            // control calculations
            M1_Control.Disable();
            M2_Control.Disable();
            control_Error = M3_Control.ControlUpdate(m3_pos, m3_vel, 1);
            // tilt error detection
            if (abs(M3_Control._pos_error) > ERROR_THRESHOLD)
                control_Error = 1;
        }
        else if (current_State == CORNER)
        {
            control_Error = 0;
            // brake off
            digitalWrite(EMO_GPIO, HIGH);

            control_Error = 0;
            control_Error += R_Control.ControlUpdate(RobotAngles.roll, RobotAngles.GetGyroX(), 0, 1, 1, 0);
            control_Error += P_Control.ControlUpdate(RobotAngles.pitch, RobotAngles.GetGyroY(), 0, 1, 1, 0);
            control_Error += Y_Control.ControlUpdate(0.0, RobotAngles.GetGyroZ(), 0, 0, 0, 0);
            // error detection
            if (abs(R_Control._pos_error) > ERROR_THRESHOLD)
                control_Error = 1;
            if (abs(P_Control._pos_error) > ERROR_THRESHOLD)
                control_Error = 1;

            // roll + pitch + yaw
            m1_vel = -0.5 * R_Control._velocity_out - P_Control._velocity_out;
            m2_vel = 1.0 * R_Control._velocity_out;
            m3_vel = -0.5 * R_Control._velocity_out + P_Control._velocity_out;

            R_Control.SetOutput(m1_vel);
            P_Control.SetOutput(m2_vel);
            Y_Control.SetOutput(m3_vel);
        }
        else
        {
            Serial.println("Error: Incorrect control state...");
            throw std::invalid_argument("Incorrect control state");
        }
    }

    // DIAGNOSTIC LOGGING
    if (millis() - diagnostic_t >= DIAGNOSTIC_PERIOD_MSEC)
    {
        // diagnostic update time
        diagnostic_late = millis() - diagnostic_t - DIAGNOSTIC_PERIOD_MSEC;
        diagnostic_t = millis();

        Tuning();
        monitorVoltage(current_State != IDLE ? 1 : 0);
        if (diag == 1)
        {
            if ((current_State == EDGE1)) // || (current_State == IDLE))
            {

                // Serial.print("Roll:");
                // Serial.print(RobotAngles.roll, 6);
                // Serial.print(", ");
                // Serial.print("Pitch:");
                // Serial.print(RobotAngles.pitch, 6);
                // Serial.print(", ");
                Serial.print("ErrorPos:");
                Serial.print(M1_Control._pos_error, 6);
                Serial.print(",");
                Serial.print("ErrorVel:");
                Serial.print(M1_Control._vel_error, 6);
                Serial.print(",");
                Serial.print("Angle:");
                Serial.print(m1_pos, 6);
                Serial.print(",");
                Serial.print("Velocity:");
                Serial.print(m1_pos, 6);
                Serial.print(",");
                Serial.print("MotorAcc:");
                Serial.print(M1_Control._accel_out, 6);
                Serial.print(", ");
                Serial.print("MotorVel:");
                Serial.print(M1_Control._velocity_out, 6);
                // Serial.print(", ");
                // Serial.print("PWM:");
                // Serial.print(M1_Control._pwm, 6);
                Serial.print(", ");
                Serial.print("TargetVel:");
                Serial.print(M1_Control.GetTarget(CONTROL_VEL), 6);
                Serial.print(", ");
                Serial.print("TargetPos:");
                Serial.print(M1_Control.GetTarget(CONTROL_FULL), 6);
                Serial.print(", ");
                Serial.print("MeasLate:");
                Serial.print(measurement_late, 6);

                Serial.println("");
            }
            else if (current_State == EDGE2)
            {
                // Serial.print("Roll:");
                // Serial.print(RobotAngles.roll, 6);
                // Serial.print(", ");
                // Serial.print("Pitch:");
                // Serial.print(RobotAngles.pitch, 6);
                // Serial.print(", ");
                Serial.print("ErrorPos:");
                Serial.print(M2_Control._pos_error, 6);
                Serial.print(",");
                Serial.print("ErrorVel:");
                Serial.print(M2_Control._vel_error, 6);
                Serial.print(",");
                Serial.print("Angle:");
                Serial.print(m2_pos, 6);
                Serial.print(",");
                Serial.print("Velocity:");
                Serial.print(m2_pos, 6);
                Serial.print(",");
                Serial.print("MotorAcc:");
                Serial.print(M2_Control._accel_out, 6);
                Serial.print(", ");
                Serial.print("MotorVel:");
                Serial.print(M2_Control._velocity_out, 6);
                // Serial.print(", ");
                // Serial.print("PWM:");
                // Serial.print(M2_Control._pwm, 6);
                Serial.print(", ");
                Serial.print("TargetVel:");
                Serial.print(M2_Control.GetTarget(CONTROL_VEL), 6);
                Serial.print(", ");
                Serial.print("TargetPos:");
                Serial.print(M2_Control.GetTarget(CONTROL_FULL), 6);
                Serial.print(", ");
                Serial.print("MeasLate:");
                Serial.print(measurement_late, 6);

                Serial.println("");
            }
            else if (current_State == EDGE3)
            {
                // Serial.print("Roll:");
                // Serial.print(RobotAngles.roll, 6);
                // Serial.print(", ");
                // Serial.print("Pitch:");
                // Serial.print(RobotAngles.pitch, 6);
                // Serial.print(", ");
                Serial.print("ErrorPos:");
                Serial.print(M3_Control._pos_error, 6);
                Serial.print(",");
                Serial.print("ErrorVel:");
                Serial.print(M3_Control._vel_error, 6);
                Serial.print(",");
                Serial.print("Angle:");
                Serial.print(m3_pos, 6);
                Serial.print(",");
                Serial.print("Velocity:");
                Serial.print(m3_pos, 6);
                Serial.print(",");
                Serial.print("MotorAcc:");
                Serial.print(M3_Control._accel_out, 6);
                Serial.print(", ");
                Serial.print("MotorVel:");
                Serial.print(M3_Control._velocity_out, 6);
                // Serial.print(", ");
                // Serial.print("PWM:");
                // Serial.print(M3_Control._pwm, 6);
                Serial.print(", ");
                Serial.print("TargetVel:");
                Serial.print(M3_Control.GetTarget(CONTROL_VEL), 6);
                Serial.print(", ");
                Serial.print("TargetPos:");
                Serial.print(M3_Control.GetTarget(CONTROL_FULL), 6);
                Serial.print(", ");
                Serial.print("MeasLate:");
                Serial.print(measurement_late, 6);

                Serial.println("");
            }
            else if (current_State == CORNER)
            {
                Serial.print("ErrorRPos:");
                Serial.print(R_Control._pos_error, 6);
                Serial.print(",");
                Serial.print("ErrorRVel:");
                Serial.print(R_Control._vel_error, 6);
                Serial.print(",");
                Serial.print("TargetRVel:");
                Serial.print(R_Control.GetTarget(CONTROL_VEL), 6);
                Serial.print(",");
                Serial.print("TargetRPos:");
                Serial.print(R_Control.GetTarget(CONTROL_FULL), 6);
                Serial.print(",");

                Serial.print("ErrorPPos:");
                Serial.print(P_Control._pos_error, 6);
                Serial.print(",");
                Serial.print("ErrorPVel:");
                Serial.print(P_Control._vel_error, 6);
                Serial.print(",");
                Serial.print("TargetPVel:");
                Serial.print(P_Control.GetTarget(CONTROL_VEL), 6);
                Serial.print(",");
                Serial.print("TargetPPos:");
                Serial.print(P_Control.GetTarget(CONTROL_FULL), 6);
                Serial.print(",");

                // Serial.print("ErrorYPos:");
                // Serial.print(Y_Control._pos_error, 6);
                // Serial.print(",");
                // Serial.print("ErrorYVel:");
                // Serial.print(Y_Control._vel_error, 6);
                // Serial.print(",");
                // Serial.print("TargetYVel:");
                // Serial.print(Y_Control.GetTarget(CONTROL_VEL), 6);
                // Serial.print(",");
                // Serial.print("TargetYPos:");
                // Serial.print(Y_Control.GetTarget(CONTROL_POS) + Y_Control.GetTarget(CONTROL_BAL), 6);

                Serial.print("M1Vel:");
                Serial.print(m1_vel, 6);
                Serial.print(",");

                Serial.print("M2Vel:");
                Serial.print(m2_vel, 6);
                Serial.print(",");

                Serial.print("M3Vel:");
                Serial.print(m3_vel, 6);
                Serial.print(",");

                // Serial.print("ErrorPPos:");
                // Serial.print(P_Control._pos_error, 6);
                // Serial.print(",");
                // Serial.print("ErrorPVel:");
                // Serial.print(P_Control._vel_error, 6);
                // Serial.print(",");
                // Serial.print("ErrorYPos:");
                // Serial.print(Y_Control._pos_error, 6);
                // Serial.print(",");
                // Serial.print("ErrorYVel:");
                // Serial.print(Y_Control._vel_error, 6);

                Serial.println("");
            }
            else
            {
                // Serial.print("AccXf:");
                // Serial.print(RobotAngles.GetAccX(), 6);
                // Serial.print(", ");
                // Serial.print("AccYf:");
                // Serial.print(RobotAngles.GetAccY(), 6);
                // Serial.print(", ");
                // Serial.print("AccZf:");
                // Serial.print(RobotAngles.GetAccZ(), 6);
                // Serial.print(",");
                Serial.print("AngleGyroX:");
                Serial.print(RobotAngles.GetGyroX(), 6);
                Serial.print(",");
                Serial.print("AngleGyroY:");
                Serial.print(RobotAngles.GetGyroY(), 6);
                Serial.print(", ");
                Serial.print("AngleGyroZ:");
                Serial.print(RobotAngles.GetGyroZ(), 6);
                Serial.print(", ");
                Serial.print("AccAngleX:");
                Serial.print(RobotAngles.accAngleX, 6);
                Serial.print(", ");
                Serial.print("AccAngleY:");
                Serial.print(RobotAngles.accAngleY, 6);
                Serial.print(", ");
                Serial.print("Roll:");
                Serial.print(RobotAngles.roll, 6);
                Serial.print(", ");
                Serial.print("Pitch:");
                Serial.print(RobotAngles.pitch, 6);
                // Serial.print(", ");
                // Serial.print("PWM:");
                // Serial.print(M1_Control._pwm, 6);
                // Serial.print(", ");
                // Serial.print("MeasLate:");
                // Serial.print(measurement_late, 6);

                Serial.println("");

                SerialBT.print(RobotAngles.roll, 6);
                SerialBT.print(", ");
                SerialBT.print(RobotAngles.pitch, 6);
                SerialBT.print(", ");
                SerialBT.print(RobotAngles.yaw, 6);
                SerialBT.println("");
            }
        }
    }
}

void monitorVoltage(int buzz)
{ // ESP32 12bit ADC with 0-3.3V input range
    // 4:1 voltage divider
    double voltage = (double)analogRead(BATT_AIN) * 3.3 / 4096.0 * 4.0;
    // SerialBT.print("monitorVoltage(): ");
    // SerialBT.print(voltage);
    // SerialBT.println(" V");
    if (voltage > 8 && voltage < 9.5 && buzz == 1)
        beep(1);
}

void Tuning()
{
    char *variableNames[5] = {"zero-crossing [Hz]", "integral cutoff [Hz]", "low-pass cutoff [Hz]", "gain", "lead-lag phase boost"};
    char *controlNames[2] = {"corner", "edge"};
    if (!Serial.available())
        return;
    char cmd = Serial.read();
    switch (cmd)
    {
    case 'd':
        if (diag == 1)
        {
            Serial.println("Diagnostic data mode disabled...");
            diag = 0;
        }
        else
        {
            Serial.println("Diagnostic data mode enabled!");
            diag = 1;
        }
        break;
    case '1':
        mode = 1;
        Serial.print(variableNames[mode - 1]);
        Serial.println(" selected");
        break;
    case '2':
        mode = 2;
        Serial.print(variableNames[mode - 1]);
        Serial.println(" selected");
        break;
    case '3':
        mode = 3;
        Serial.print(variableNames[mode - 1]);
        Serial.println(" selected");
        break;
    case '4':
        mode = 4;
        Serial.print(variableNames[mode - 1]);
        Serial.println(" selected");
        break;
    case '5':
        mode = 5;
        Serial.print(variableNames[mode - 1]);
        Serial.println(" selected");
        break;
    case 'v':
        Serial.println("Velocity control loop selected");
        if (edge == 1)
            controlIdx = 0;
        else
            controlIdx = 3;
        break;
    case 'p':
        Serial.println("Position control loop selected");
        if (edge == 1)
            controlIdx = 1;
        else
            controlIdx = 4;
        break;
    case 'b':
        Serial.println("Balance control loop selected");
        if (edge == 1)
            controlIdx = 2;
        else
            controlIdx = 5;
        break;
    case 'e':
        if (edge == 1)
        {
            Serial.println("Corner control loop selected");
            edge = 0;
        }
        else
        {
            Serial.println("Edge control loop selected");
            edge = 1;
        }
        break;
    case '+':
        control_gains[controlIdx][mode - 1] *= 1.1;
        if (mode == 5)
        {
            if (control_gains[controlIdx][mode - 1] == 0)
                control_gains[controlIdx][mode - 1] = 1.0;
        }
        Serial.print("increased ");
        Serial.print(controlNames[edge]);
        Serial.print(" ");
        Serial.print(variableNames[mode - 1]);
        Serial.print(" -> ");
        Serial.println(control_gains[controlIdx][mode - 1], 6);
        CalcGains(controlIdx);
        break;
    case '-':
        control_gains[controlIdx][mode - 1] *= 0.9;
        if (mode == 5)
        {
            if (control_gains[controlIdx][mode - 1] < 1.0)
                control_gains[controlIdx][mode - 1] = 0.0;
        }
        Serial.print("decreased ");
        Serial.print(controlNames[edge]);
        Serial.print(" ");
        Serial.print(variableNames[mode - 1]);
        Serial.print(" -> ");
        Serial.println(control_gains[controlIdx][mode - 1], 6);
        CalcGains(controlIdx);
        break;

    case 's':
        Stop();
        delay(2000);
        break;
    }
}

void CalcGains(int controlIdx)
{
    if (controlIdx == 0 || controlIdx < 0)
    {
        M1_Control.CalcGains(control_gains[0][0], control_gains[0][1], control_gains[0][2], control_gains[0][3], control_gains[0][4], CONTROL_VEL, 1);
        M2_Control.CalcGains(control_gains[0][0], control_gains[0][1], control_gains[0][2], control_gains[0][3], control_gains[0][4], CONTROL_VEL, 0);
        M3_Control.CalcGains(control_gains[0][0], control_gains[0][1], control_gains[0][2], control_gains[0][3], control_gains[0][4], CONTROL_VEL, 0);
    }
    if (controlIdx == 1 || controlIdx < 0)
    {
        M1_Control.CalcGains(control_gains[1][0], control_gains[1][1], control_gains[1][2], control_gains[1][3], control_gains[1][4], CONTROL_POS, 1);
        M2_Control.CalcGains(control_gains[1][0], control_gains[1][1], control_gains[1][2], control_gains[1][3], control_gains[1][4], CONTROL_POS, 0);
        M3_Control.CalcGains(control_gains[1][0], control_gains[1][1], control_gains[1][2], control_gains[1][3], control_gains[1][4], CONTROL_POS, 0);
    }
    if (controlIdx == 2 || controlIdx < 0)
    {
        M1_Control.CalcGains(control_gains[2][0], control_gains[2][1], control_gains[2][2], control_gains[2][3], control_gains[2][4], CONTROL_BAL, 1);
        M2_Control.CalcGains(control_gains[2][0], control_gains[2][1], control_gains[2][2], control_gains[2][3], control_gains[2][4], CONTROL_BAL, 0);
        M3_Control.CalcGains(control_gains[2][0], control_gains[2][1], control_gains[2][2], control_gains[2][3], control_gains[2][4], CONTROL_BAL, 0);
    }
    if (controlIdx == 3 || controlIdx < 0)
    {
        R_Control.CalcGains(control_gains[3][0], control_gains[3][1], control_gains[3][2], control_gains[3][3], control_gains[3][4], CONTROL_VEL, 1);
        P_Control.CalcGains(control_gains[3][0], control_gains[3][1], control_gains[3][2], control_gains[3][3], control_gains[3][4], CONTROL_VEL, 0);
        Y_Control.CalcGains(control_gains[3][0], control_gains[3][1], control_gains[3][2], control_gains[3][3], control_gains[3][4], CONTROL_VEL, 0);
    }
    if (controlIdx == 4 || controlIdx < 0)
    {
        R_Control.CalcGains(control_gains[4][0], control_gains[4][1], control_gains[4][2], control_gains[4][3], control_gains[4][4], CONTROL_POS, 1);
        P_Control.CalcGains(control_gains[4][0], control_gains[4][1], control_gains[4][2], control_gains[4][3], control_gains[4][4], CONTROL_POS, 0);
        Y_Control.CalcGains(control_gains[4][0], control_gains[4][1], control_gains[4][2], control_gains[4][3], control_gains[4][4], CONTROL_POS, 0);
    }
    if (controlIdx == 5 || controlIdx < 0)
    {
        R_Control.CalcGains(control_gains[5][0], control_gains[5][1], control_gains[5][2], control_gains[5][3], control_gains[5][4], CONTROL_BAL, 1);
        P_Control.CalcGains(control_gains[5][0], control_gains[5][1], control_gains[5][2], control_gains[5][3], control_gains[5][4], CONTROL_BAL, 0);
        Y_Control.CalcGains(control_gains[5][0], control_gains[5][1], control_gains[5][2], control_gains[5][3], control_gains[5][4], CONTROL_BAL, 0);
    }
}
