rgraetz/cubli-redux/(commit log)

2022-11-26 initial version - working IMU, control in progress
2022-12-05 Single edge control in fully cube config
    Leaky control = stable control
    [AngleTransformation.cpp, AngleTransformation.h, ControlAlgo.cpp, ControlAlgo.h, DigitalEncoder.cpp, DigitalEncoder.h, DiscreteFilter.cpp, DiscreteFilter.h]
2022-12-07 parallel dual velocity/position loop
2022-12-08 nested position and velocity control
2022-12-11 initial EE design
    [Cublic - Copy.csv, Cublic - Copy.ods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]
2022-12-11 initial ME design
    [1X_CustomSupport_ReactionWheel-Part.3mf, 2X_CustomSupport_ReactionWheel-Part.3mf, BatteryMount-Body.stl, BatteryMount.FCStd, BatteryMount_New-Body.stl, BatteryMount_New.FCStd, ElectronicsMount-Part.3mf, ElectronicsMount-Part.stl]
2022-12-11 support files
    [test.csv]
